bbenchoff/6502SBC/SBC.brd

## EAGLE design SBC.brd (2013-04-03)

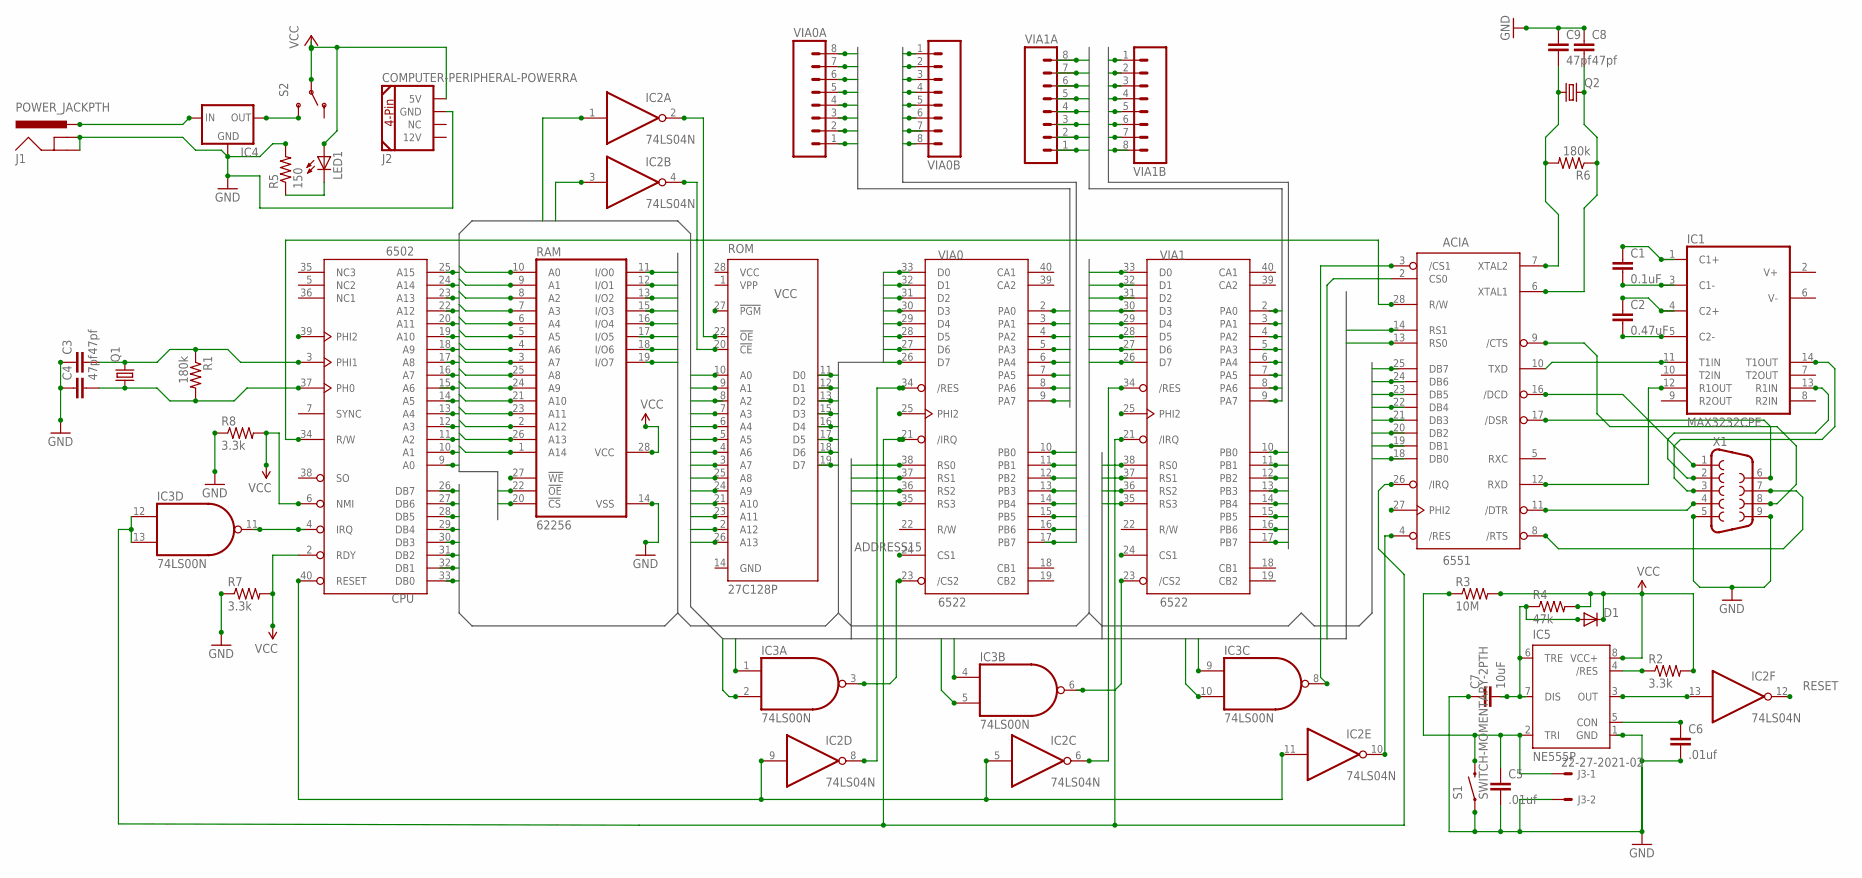
[picture p1: schematic SBC.sch]

Parts:
ACIA: 6551; DIP28
C1: 0.1uF; CAP-PTH-SMALL-KIT
C2: 0.47uF; CAP-PTH-SMALL-KIT
C3, C4, C8, C9: 47pf; CAP-PTH-SMALLEZ
C5, C6: .01uf; CAP-PTH-SMALLEZ
C7: 10uF; CAP-PTH-SMALLEZ
CPU: 6502; DIP40
D1: DIODE1N4148; DIODE-1N4148
IC1: MAX3232CPE; DIL16
IC2: 74LS04N; DIL14
IC3: 74LS00N; DIL14
IC4: V_REG_78XX-TO-220; TO-220-ALT
IC5: NE555P; DIL-08
J1: POWER_JACKPTH; POWER_JACK_PTH
J2: COMPUTER-PERIPHERAL-POWERRA; COMPUTER-PERIPHERAL-POWER-RA
J3: 22-27-2021-02; 6410-02
LED1: LED3MM
Q1, Q2: CRYSTALHC49S; HC49/S
R1, R6: 180k; AXIAL-0.3EZ
R2: 3.3k; AXIAL-0.3
R3: 10M; AXIAL-0.3
R4: 47k; AXIAL-0.3
R5: 150; AXIAL-0.3EZ
R7, R8: 3.3k; AXIAL-0.3EZ
RAM: 62256; DIL28-6
ROM: 27C128P; DIL28-6
S1: SWITCH-MOMENTARY-2PTH; TACTILE-PTH
S2: SWITCH-SPDTPTH_LOCK; SWITCH-SPDT_LOCK.007S
VIA0, VIA1: 6522; DIP40
VIA0A, VIA0B, VIA1A, VIA1B: M08LONGPADS; 1X08_LONGPADS
X1: DB9FEMALE; DB9

Connections:
65IRQ: CPU.4 (IRQ), IC3.11 (O)
ADDRESS0: ACIA.13 (RS0), CPU.9 (A0), RAM.10 (A0), ROM.10 (A0), VIA0.38 (RS0), VIA1.38 (RS0)
ADDRESS1: ACIA.14 (RS1), CPU.10 (A1), RAM.9 (A1), ROM.9 (A1), VIA0.37 (RS1), VIA1.37 (RS1)
ADDRESS2: CPU.11 (A2), RAM.8 (A2), ROM.8 (A2), VIA0.36 (RS2), VIA1.36 (RS2)
ADDRESS3: CPU.12 (A3), RAM.7 (A3), ROM.7 (A3), VIA0.35 (RS3), VIA1.35 (RS3)
ADDRESS4: CPU.13 (A4), RAM.6 (A4), ROM.6 (A4)
ADDRESS5: CPU.14 (A5), RAM.5 (A5), ROM.5 (A5)
ADDRESS6: CPU.15 (A6), RAM.4 (A6), ROM.4 (A6)
ADDRESS7: CPU.16 (A7), RAM.3 (A7), ROM.3 (A7)
ADDRESS8: CPU.17 (A8), RAM.25 (A8), ROM.25 (A8)
ADDRESS9: CPU.18 (A9), IC3.10 (I1), RAM.24 (A9), ROM.24 (A9)
ADDRESS10: CPU.19 (A10), IC3.5 (I1), RAM.21 (A10), ROM.21 (A10)
ADDRESS11: CPU.20 (A11), IC3.2 (I1), RAM.23 (A11), ROM.23 (A11)
ADDRESS12: CPU.22 (A12), IC3.1 (I0), IC3.4 (I0), IC3.9 (I0), RAM.2 (A12), ROM.2 (A12)
ADDRESS13: CPU.23 (A13), IC2.1 (I), RAM.26 (A13), ROM.26 (A13)
ADDRESS14: CPU.24 (A14), RAM.1 (A14)
ADDRESS15: ACIA.2 (CS0), CPU.25 (A15), IC2.3 (I), RAM.20 (!CS), RAM.22 (!OE), VIA0.24 (CS1), VIA1.24 (CS1)
CLEARTOSEND: ACIA.9 (/CTS), X1.8
DATA0: ACIA.18 (DB0), CPU.33 (DB0), RAM.11 (I/O0), ROM.11 (D0), VIA0.33 (D0), VIA1.33 (D0)
DATA1: ACIA.19 (DB1), CPU.32 (DB1), RAM.12 (I/O1), ROM.12 (D1), VIA0.32 (D1), VIA1.32 (D1)
DATA2: ACIA.20 (DB2), CPU.31 (DB2), RAM.13 (I/O2), ROM.13 (D2), VIA0.31 (D2), VIA1.31 (D2)
DATA3: ACIA.21 (DB3), CPU.30 (DB3), RAM.15 (I/O3), ROM.15 (D3), VIA0.30 (D3), VIA1.30 (D3)
DATA4: ACIA.22 (DB4), CPU.29 (DB4), RAM.16 (I/O4), ROM.16 (D4), VIA0.29 (D4), VIA1.29 (D4)
DATA5: ACIA.23 (DB5), CPU.28 (DB5), RAM.17 (I/O5), ROM.17 (D5), VIA0.28 (D5), VIA1.28 (D5)
DATA6: ACIA.24 (DB6), CPU.27 (DB6), RAM.18 (I/O6), ROM.18 (D6), VIA0.27 (D6), VIA1.27 (D6)
DATA7: ACIA.25 (DB7), CPU.26 (DB7), RAM.19 (I/O7), ROM.19 (D7), VIA0.26 (D7), VIA1.26 (D7)
DATACARRIERDETECT: ACIA.16 (/DCD), X1.1
DATASETREADY: ACIA.17 (/DSR), X1.6
DTEREADY: ACIA.11 (/DTR), X1.4
GND: ACIA.1 (GND), C3.1, C4.1, C5.2, C6.2, C7.1, C8.1, C9.1, CPU.1 (GND), CPU.21 (GND), IC1.15 (GND), IC2.7 (GND), IC3.7 (GND), IC4.GND, IC5.1 (GND), J1.GND, J1.GNDBREAK, J2.GND, J3.2, R5.P$2 (2), R7.P$1 (1), R8.P$1 (1), RAM.14 (VSS), ROM.14 (GND), S1.1, VIA0.1 (GND), VIA1.1 (GND), X1.5, X1.9
IRQ: ACIA.26 (/IRQ), IC3.12 (I0), IC3.13 (I1), VIA0.21 (/IRQ), VIA1.21 (/IRQ)
unnamed: LED1.K (C), R5.P$1 (1)
unnamed: C3.2, CPU.3 (PHI1), Q1.2, R1.P$1 (1)
unnamed: IC1.14 (T1OUT), X1.3
unnamed: ACIA.28 (R/W), CPU.34 (R/W)
unnamed: C5.1, IC5.2 (TRI), J3.1, R3.P$1 (1), S1.3 (2)
unnamed: ACIA.10 (TXD), IC1.11 (T1IN)
unnamed: ACIA.12 (RXD), IC1.12 (R1OUT)
unnamed: C1.2, IC1.3 (C1-)
unnamed: C1.1, IC1.1 (C1+)
unnamed: C2.2, IC1.5 (C2-)
unnamed: C2.1, IC1.4 (C2+)
unnamed: IC2.4 (O), ROM.20 (!CE)
unnamed: IC2.2 (O), ROM.22 (!OE)
unnamed: IC3.6 (O), VIA1.23 (/CS2)
unnamed: ACIA.3 (/CS1), IC3.8 (O)
unnamed: IC3.3 (O), VIA0.23 (/CS2)
unnamed: C4.2, CPU.37 (PH0), Q1.1, R1.P$2 (2)
unnamed: C6.1, IC5.5 (CON)
unnamed: IC4.IN, J1.PWR
unnamed: IC2.8 (O), VIA0.34 (/RES)
unnamed: C7.2, D1.A, IC5.6 (TRE), IC5.7 (DIS), R4.P$1 (1)
unnamed: IC5.4 (/RES), R2.P$1 (1)
unnamed: IC2.6 (O), VIA1.34 (/RES)
unnamed: ACIA.4 (/RES), IC2.10 (O)
unnamed: IC2.13 (I), IC5.3 (OUT)
unnamed: ACIA.6 (XTAL1), C8.2, Q2.2, R6.P$1 (1)
unnamed: ACIA.7 (XTAL2), C9.2, Q2.1, R6.P$2 (2)
unnamed: IC4.OUT, S2.3 (S)
PHI2: ACIA.27 (PHI2), CPU.39 (PHI2), RAM.27 (!WE), VIA0.25 (PHI2), VIA1.25 (PHI2)
RECEIVEDATA: IC1.13 (R1IN), X1.2
REQUESTTOSEND: ACIA.8 (/RTS), X1.7
RESET: CPU.40 (RESET), IC2.5 (I), IC2.9 (I), IC2.11 (I), IC2.12 (O)
VCC: ACIA.15 (VCC), CPU.2 (RDY), CPU.6 (NMI), CPU.8 (VCC), D1.C, IC1.16 (VCC), IC2.14 (VCC), IC3.14 (VCC), IC5.8 (VCC+), J2.5V, LED1.A, R2.P$2 (2), R3.P$2 (2), R4.P$2 (2), R7.P$2 (2), R8.P$2 (2), RAM.28 (VCC), ROM.27 (!PGM), ROM.28 (VCC), S2.2, VIA0.20 (VCC), VIA1.20 (VCC)
VIA0A0: VIA0.2 (PA0), VIA0A.1
VIA0A1: VIA0.3 (PA1), VIA0A.2
VIA0A2: VIA0.4 (PA2), VIA0A.3
VIA0A3: VIA0.5 (PA3), VIA0A.4
VIA0A4: VIA0.6 (PA4), VIA0A.5
VIA0A5: VIA0.7 (PA5), VIA0A.6
VIA0A6: VIA0.8 (PA6), VIA0A.7
VIA0A7: VIA0.9 (PA7), VIA0A.8
VIA0B0: VIA0.10 (PB0), VIA0B.1
VIA0B1: VIA0.11 (PB1), VIA0B.2
VIA0B2: VIA0.12 (PB2), VIA0B.3
VIA0B3: VIA0.13 (PB3), VIA0B.4
VIA0B4: VIA0.14 (PB4), VIA0B.5
VIA0B5: VIA0.15 (PB5), VIA0B.6
VIA0B6: VIA0.16 (PB6), VIA0B.7
VIA0B7: VIA0.17 (PB7), VIA0B.8
VIA1A0: VIA1.2 (PA0), VIA1A.1
VIA1A1: VIA1.3 (PA1), VIA1A.2
VIA1A2: VIA1.4 (PA2), VIA1A.3
VIA1A3: VIA1.5 (PA3), VIA1A.4
VIA1A4: VIA1.6 (PA4), VIA1A.5
VIA1A5: VIA1.7 (PA5), VIA1A.6
VIA1A6: VIA1.8 (PA6), VIA1A.7
VIA1A7: VIA1.9 (PA7), VIA1A.8
VIA1B0: VIA1.10 (PB0), VIA1B.1
VIA1B1: VIA1.11 (PB1), VIA1B.2
VIA1B2: VIA1.12 (PB2), VIA1B.3
VIA1B3: VIA1.13 (PB3), VIA1B.4
VIA1B4: VIA1.14 (PB4), VIA1B.5
VIA1B5: VIA1.15 (PB5), VIA1B.6
VIA1B6: VIA1.16 (PB6), VIA1B.7
VIA1B7: VIA1.17 (PB7), VIA1B.8

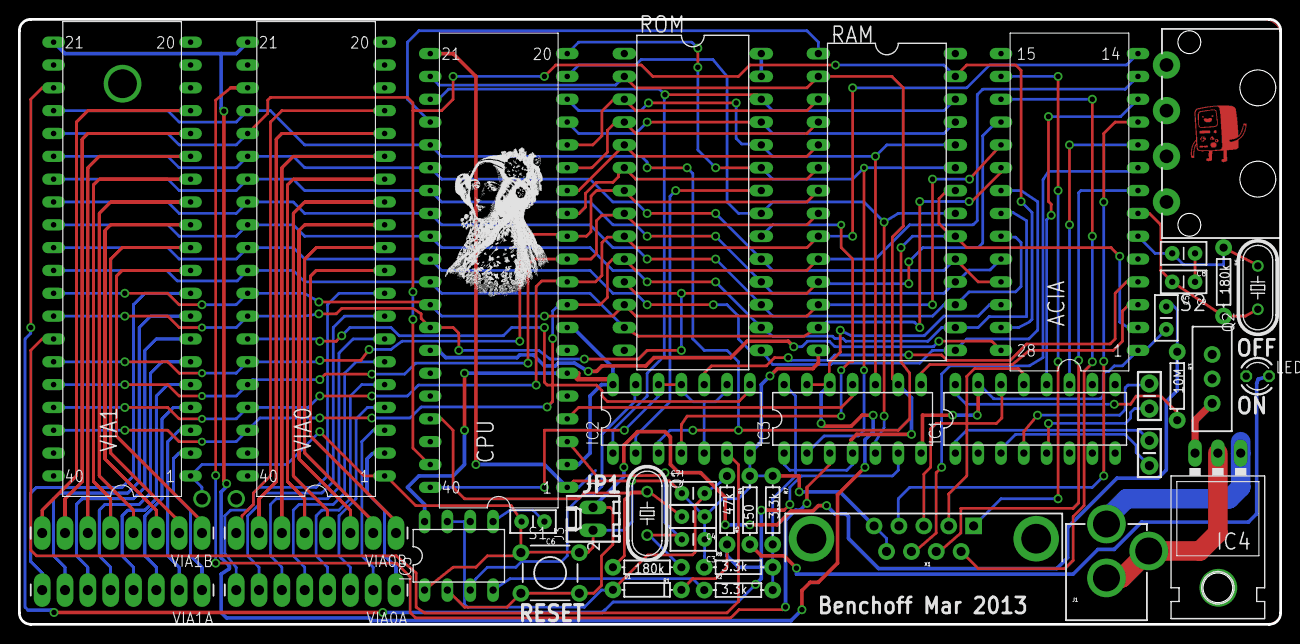
[picture p2: board SBC.brd from above]

Board: 2 copper layers, 140.3 x 67.3 mm, 42 parts (0 on the bottom side), 96 nets.
