bbenchoff/6502SBC/(commit log)

2013-03-29 First Commit
    BOM, board, and schematic
    [SBC.brd, SBC.sch]
2013-03-31 Added gerber files
    [SBC.brd, SBC.sch]
2013-04-03 Fixed issue with SMD switch
    Updated schematic, board, BOM & gerbers for through-hole switch. Sent
    gerber off to production.
    [SBC.brd, SBC.sch]
